Glinek/capibaraZero-FORK/Photos/20250617_205448.jpg

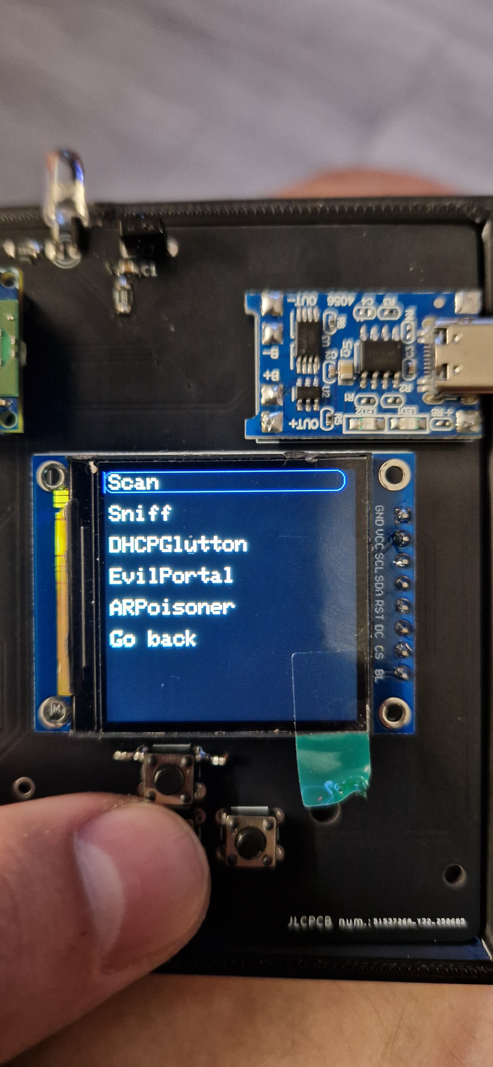
Photos/20250617_205448.jpg
