Glinek/capibaraZero-FORK/Photos/20250602_191517.jpg

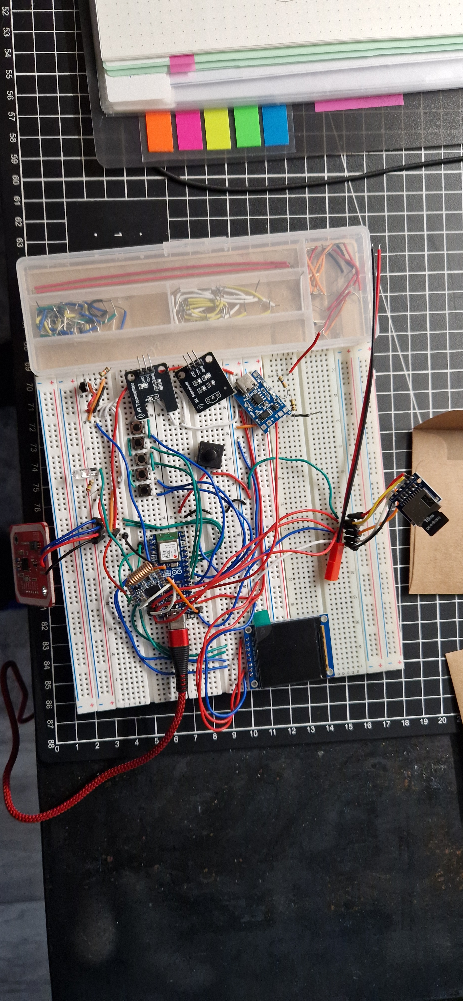
Photos/20250602_191517.jpg
