Glinek/capibaraZero-FORK/README.md

# CapibaraZero FORK
This repo contains PCBs designed by me for [the capibara zero](https://capibarazero.com/). 

### Gerber files are located under /KiCad/fabrication files for PCB
