Glinek/capibaraZero-FORK/Photos/20250513_170703.jpg

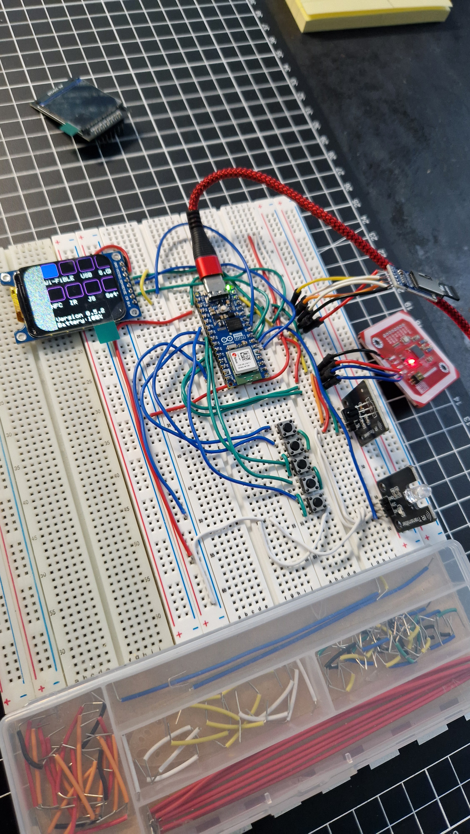
Photos/20250513_170703.jpg
