Glinek/capibaraZero-FORK/Photos/20250602_181604.jpg

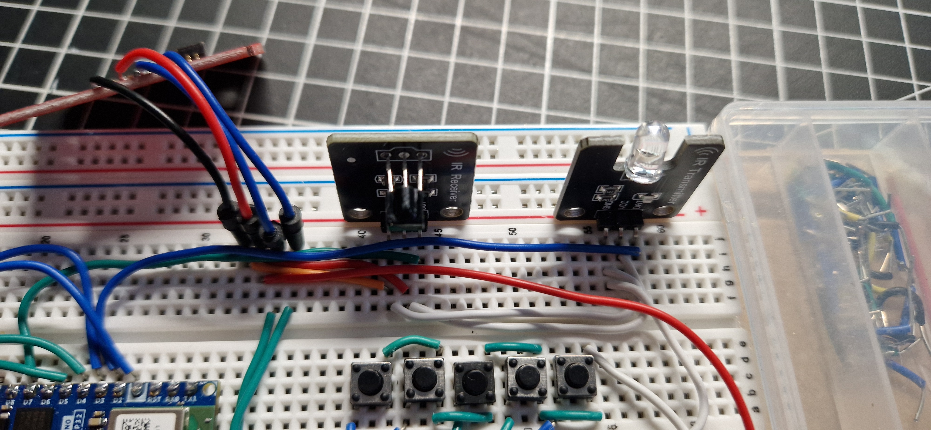
Photos/20250602_181604.jpg
