Glinek/capibaraZero-FORK/Photos/20250602_191530.jpg

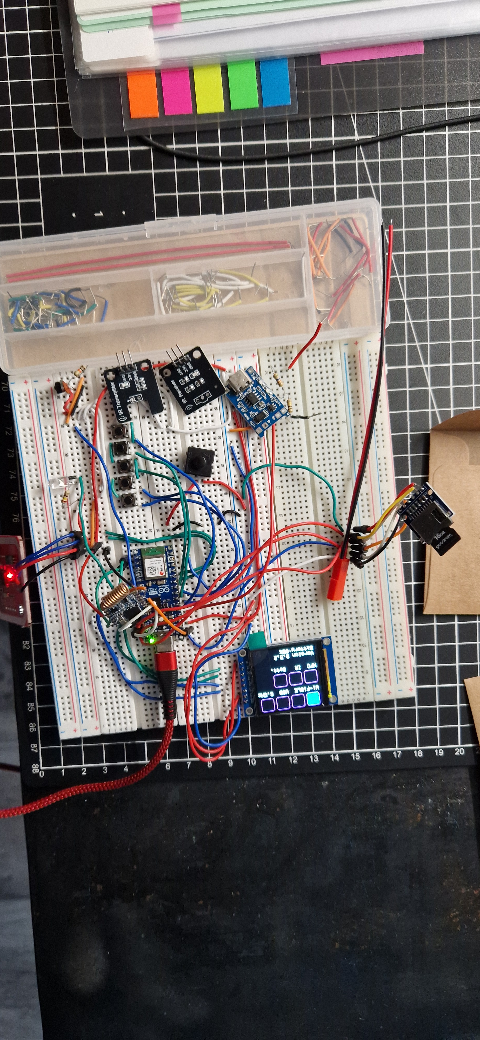
Photos/20250602_191530.jpg
