Glinek/capibaraZero-FORK/Photos/20250604_070136.jpg

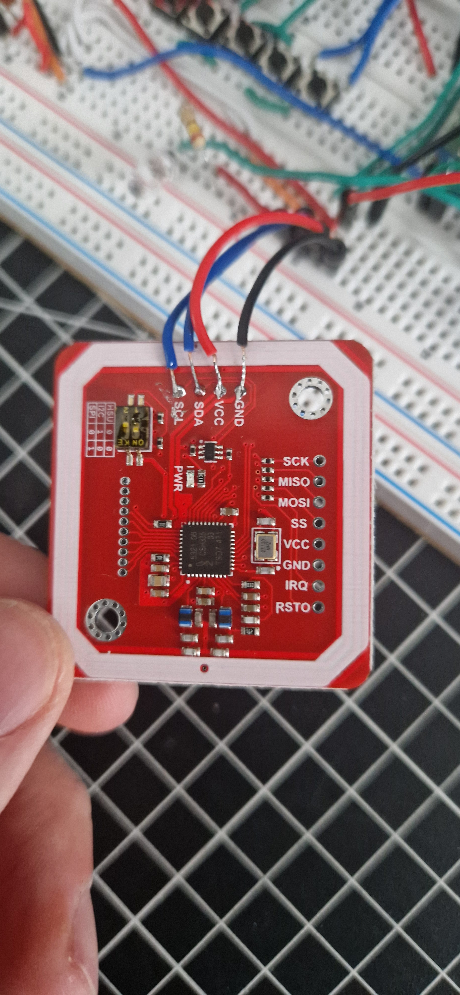
Photos/20250604_070136.jpg
