Glinek/capibaraZero-FORK/Photos/20250604_070140.jpg

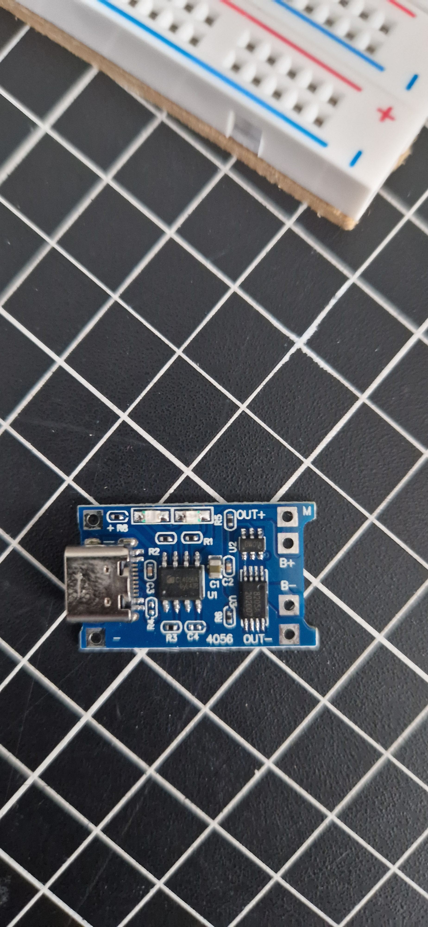
Photos/20250604_070140.jpg
