Glinek/capibaraZero-FORK/Photos/20250604_070147.jpg

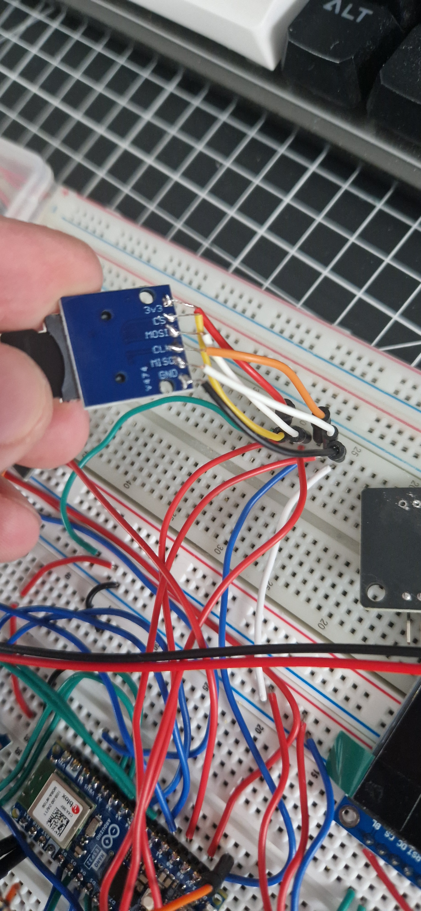
Photos/20250604_070147.jpg
