Glinek/capibaraZero-FORK/Photos/20250616_064222.jpg

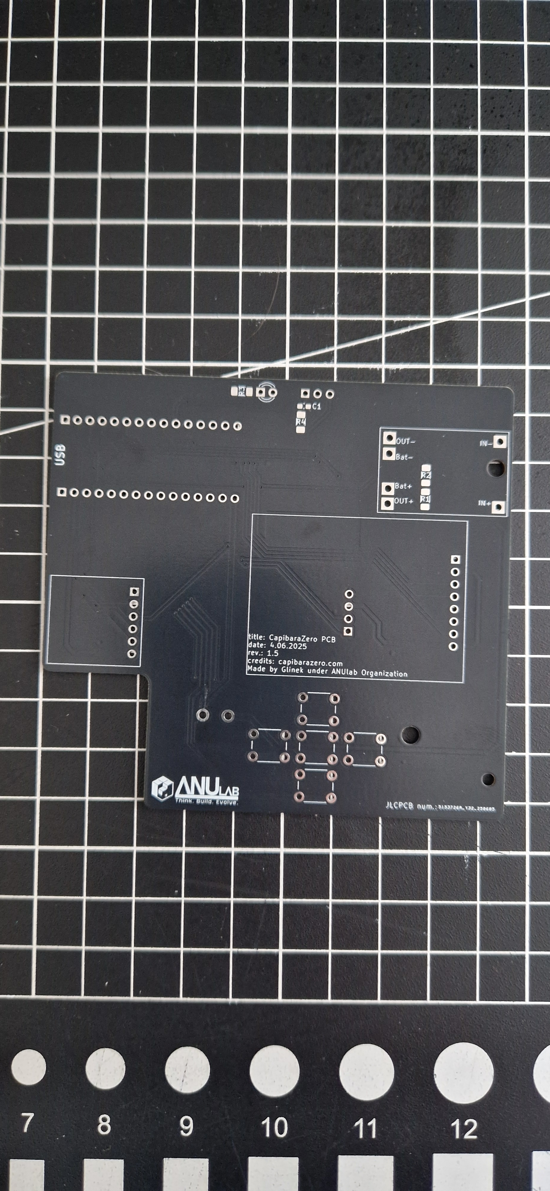
Photos/20250616_064222.jpg
