Glinek/capibaraZero-FORK/Photos/20250616_184949.jpg

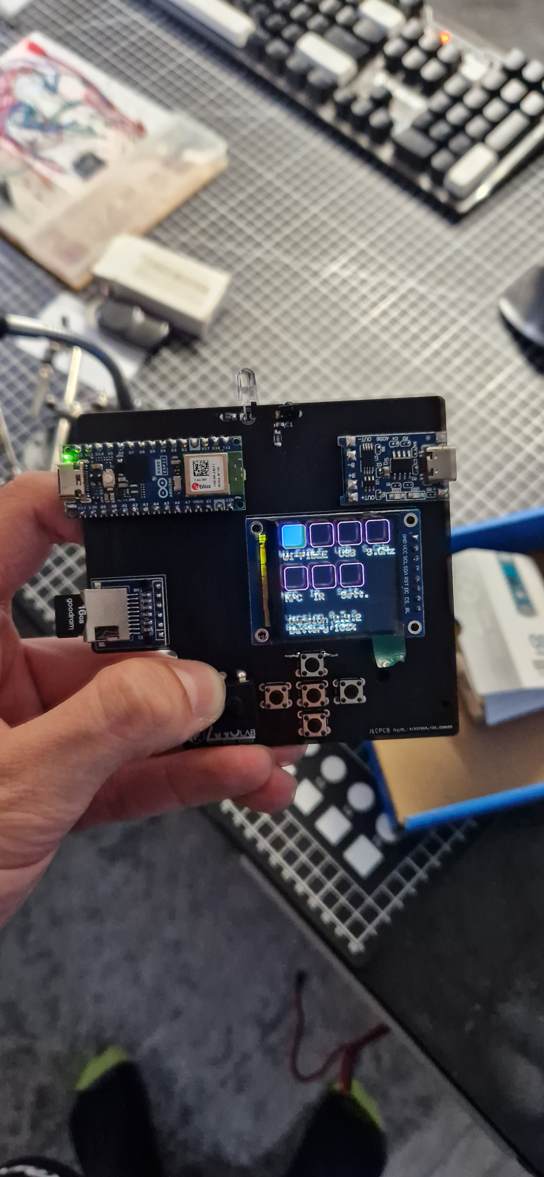
Photos/20250616_184949.jpg
