Glinek/capibaraZero-FORK/Photos/20250616_184953.jpg

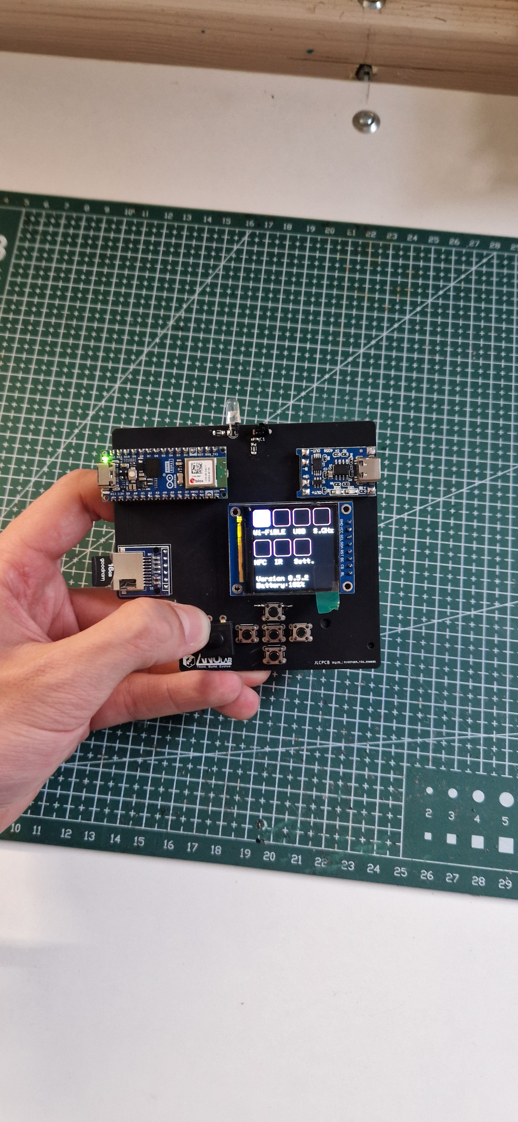
Photos/20250616_184953.jpg
