Glinek/capibaraZero-FORK/Photos/20250616_184956.jpg

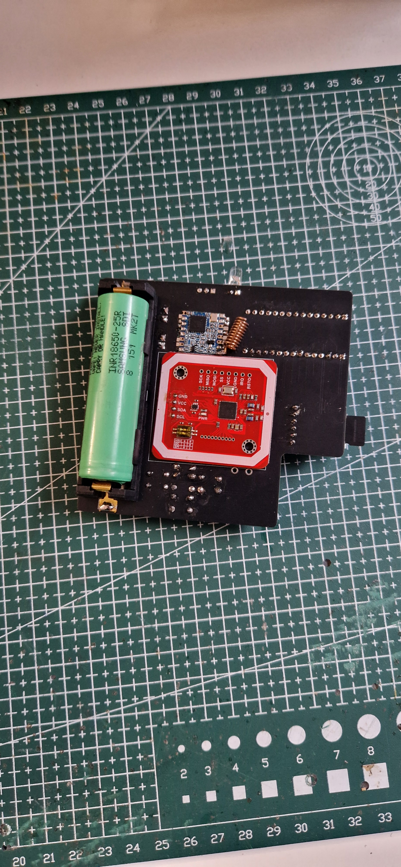
Photos/20250616_184956.jpg
