Glinek/capibaraZero-FORK/Photos/20250617_205459.jpg

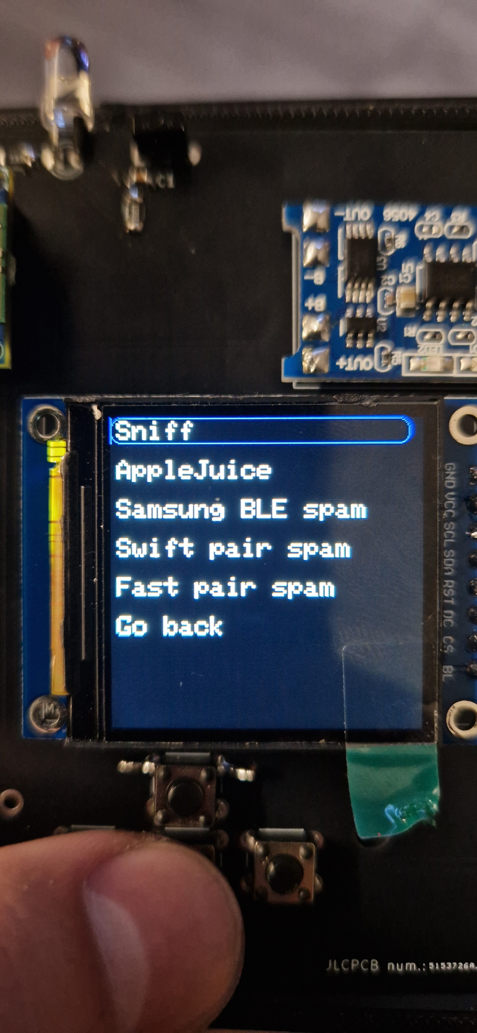
Photos/20250617_205459.jpg
