Glinek/capibaraZero-FORK/Photos/20250617_205542.jpg

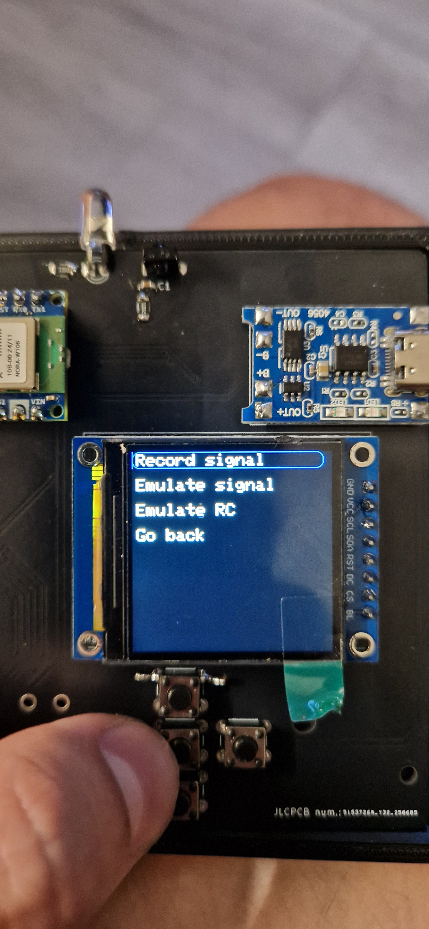
Photos/20250617_205542.jpg
