Glinek/capibaraZero-FORK/Photos/20250622_161914.jpg

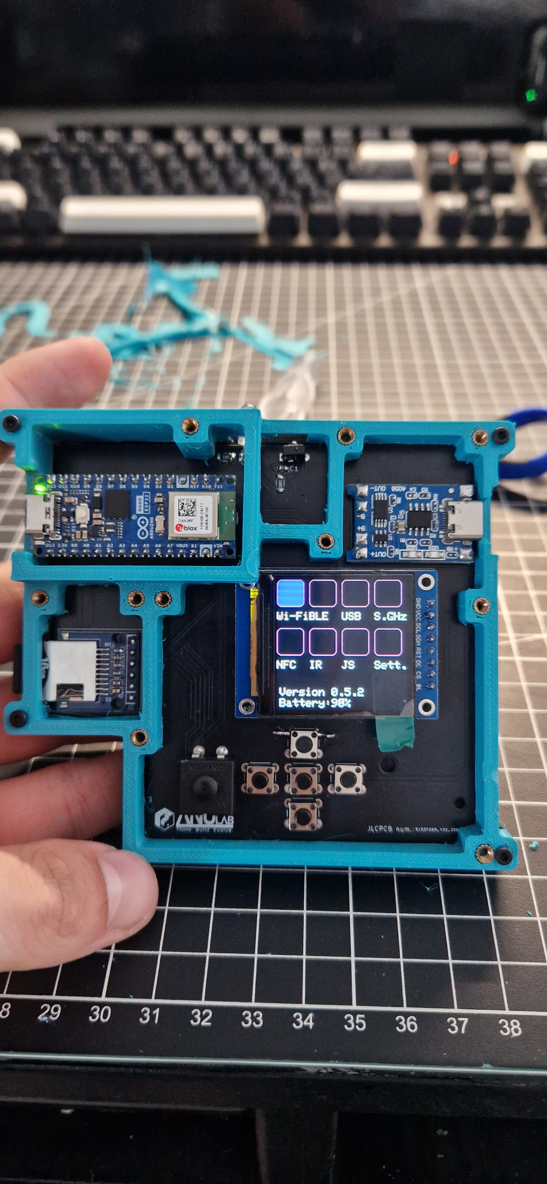
Photos/20250622_161914.jpg
