Glinek/capibaraZero-FORK/Photos/20250622_161920.jpg

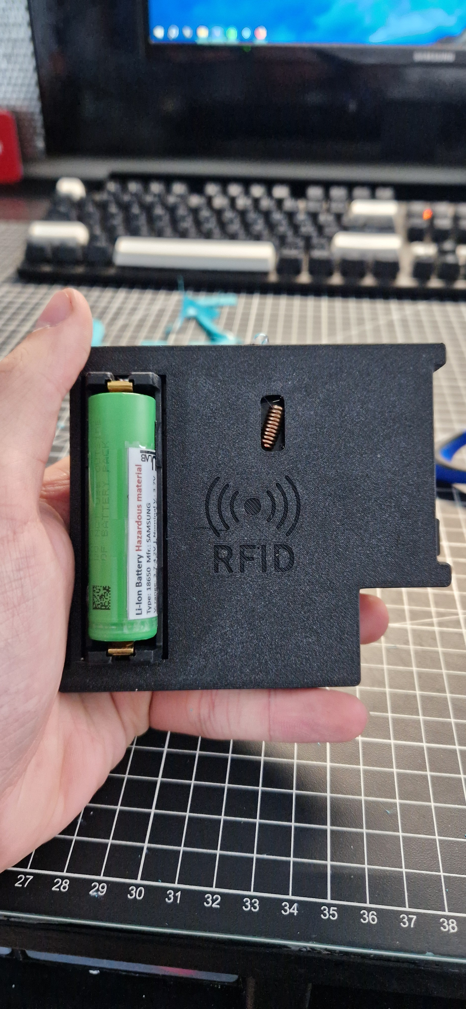
Photos/20250622_161920.jpg
