Glinek/capibaraZero-FORK/Photos/20250623_212616.jpg

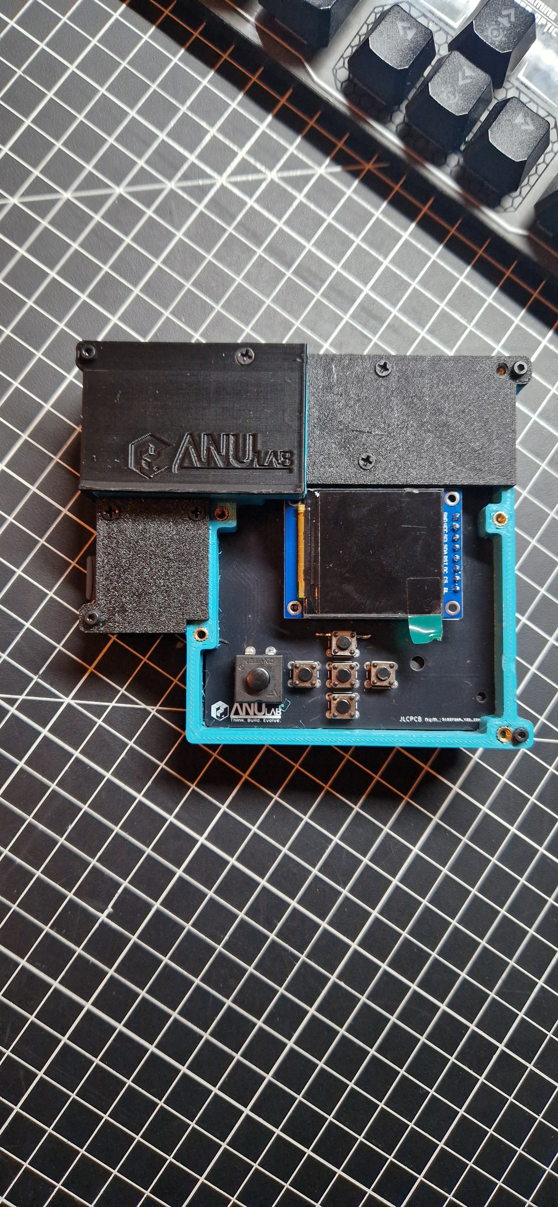
Photos/20250623_212616.jpg
