Glinek/capibaraZero-FORK/Photos/20250626_183406.jpg

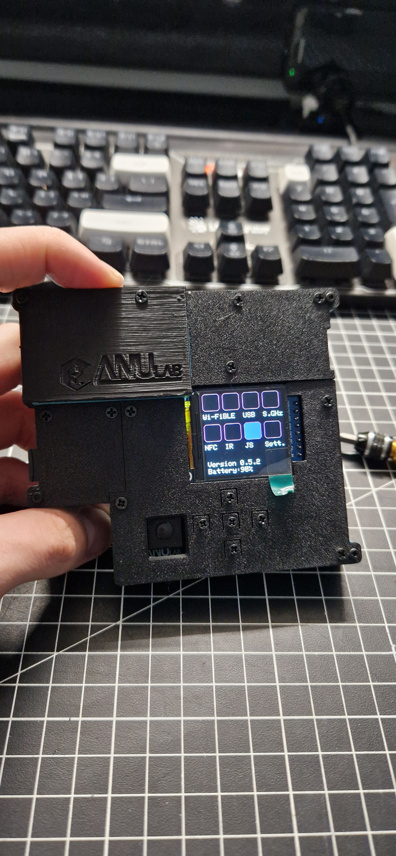
Photos/20250626_183406.jpg
