Glinek/capibaraZero-FORK/CAD files/FreeCAD/mainCover.FCStd

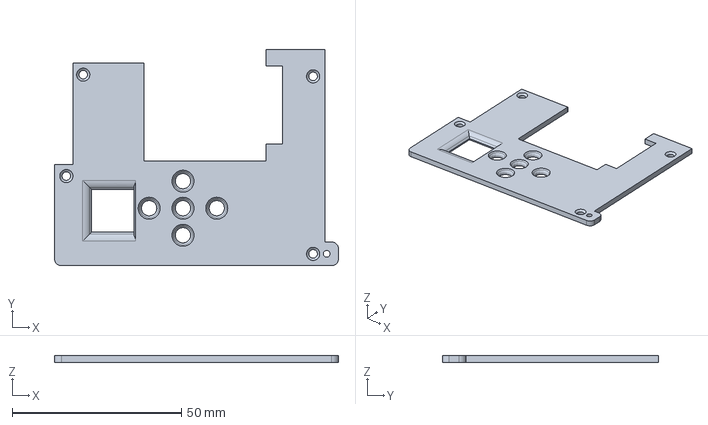
[picture p30: CAD file, 2025-11-09]
CAD files/FreeCAD/mainCover.FCStd
84.0 x 64.0 x 2.00 mm
