Glinek/capibaraZero-FORK/SD card folders/STLs/mainCover-v4.stl

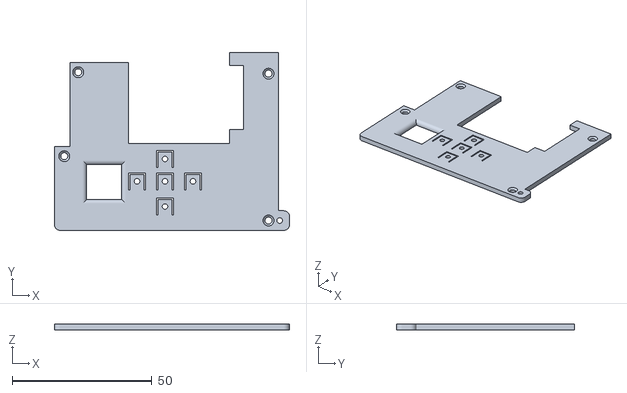
[picture p31: CAD file, 2025-06-26]
SD card folders/STLs/mainCover-v4.stl
84.0 x 63.5 x 2.00
