Glinek/capibaraZero-FORK/CAD files/FreeCAD/fullAssembly.FCStd

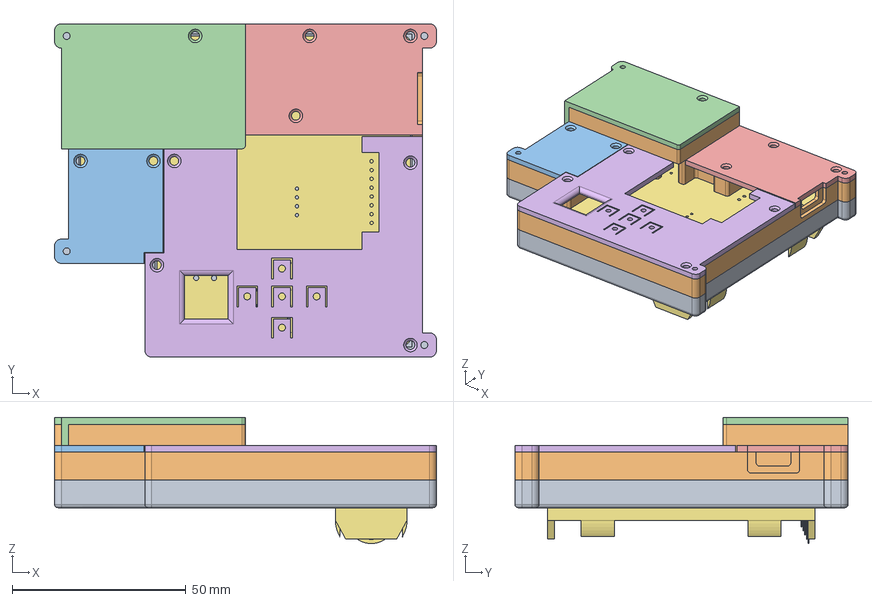
[picture p32: CAD file, 2025-06-26]
CAD files/FreeCAD/fullAssembly.FCStd
110.0 x 96.0 x 36.3 mm
bottomPart_001
topPart_001
sdCover_001
arduinoCover_001
irBmsCover_001
mainCover_001
capibarazeroPCB1_001
