Glinek/capibaraZero-FORK/CAD files/FreeCAD/arduinoCover.FCStd

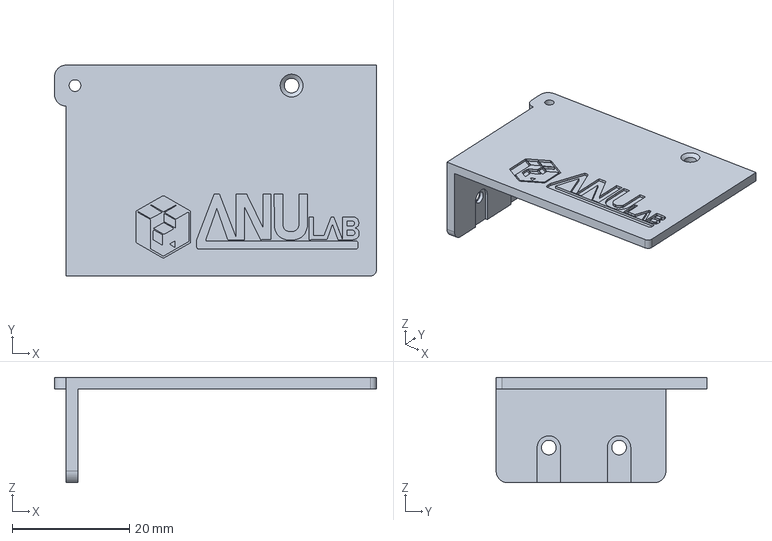
[picture p33: CAD file, 2025-06-26]
CAD files/FreeCAD/arduinoCover.FCStd
55.0 x 36.0 x 18.0 mm
