Glinek/capibaraZero-FORK/CAD files/STLs final/arduinoCover-v1,5.stl

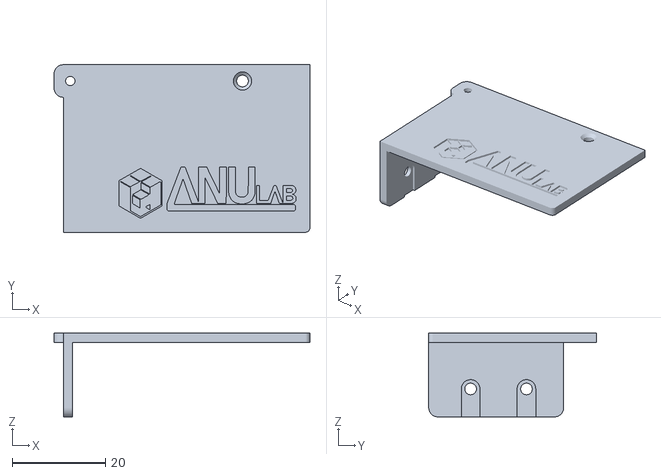
[picture p34: CAD file, 2025-06-26]
CAD files/STLs final/arduinoCover-v1,5.stl
55.0 x 36.0 x 18.0
