Glinek/capibaraZero-FORK/CAD files/STLs final/irBmsCove-v2.stl

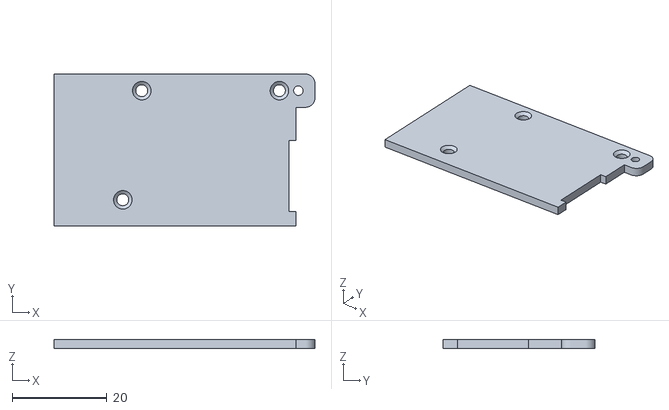
[picture p35: CAD file, 2025-06-26]
CAD files/STLs final/irBmsCove-v2.stl
55.0 x 32.0 x 2.00
