Glinek/capibaraZero-FORK/CAD files/STLs final/topPart-v3.stl

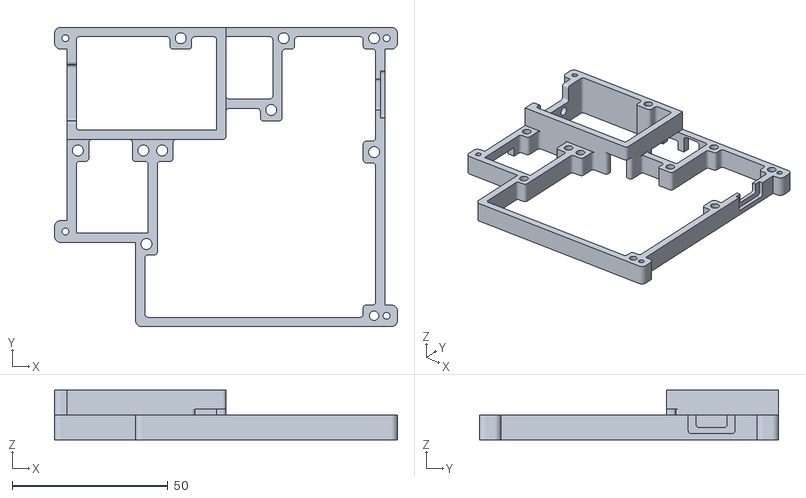
[picture p36: CAD file, 2025-06-26]
CAD files/STLs final/topPart-v3.stl
110.0 x 96.0 x 16.0
