Glinek/capibaraZero-FORK/CAD files/FreeCAD/sdCover.FCStd

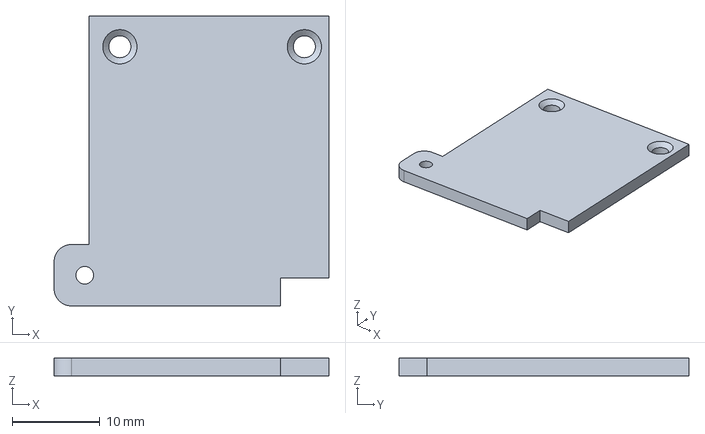
[picture p37: CAD file, 2025-06-26]
CAD files/FreeCAD/sdCover.FCStd
31.3 x 33.0 x 2.00 mm
