Glinek/capibaraZero-FORK/CAD files/FreeCAD/capibarazeroPCBv3.FCStd

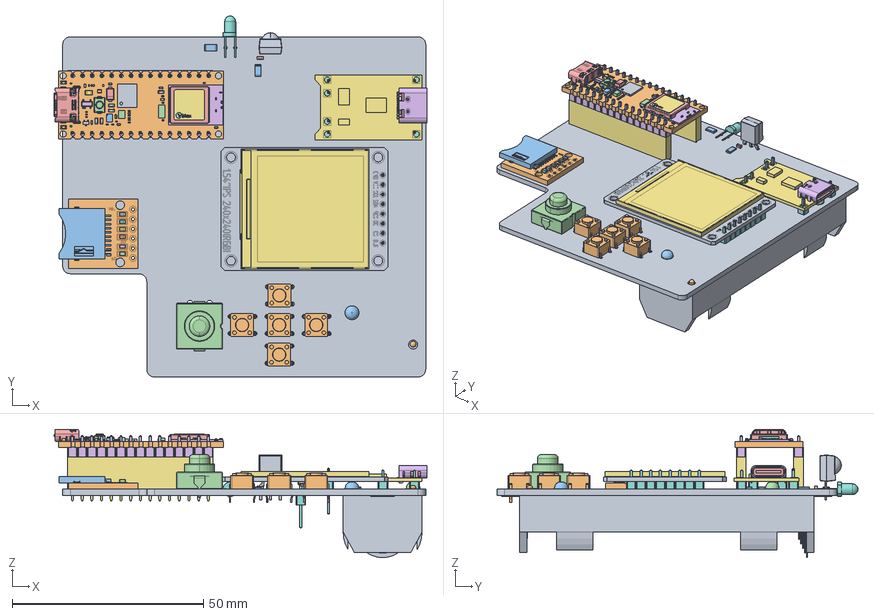
[picture p38: CAD file, 2025-06-26]
CAD files/FreeCAD/capibarazeroPCBv3.FCStd
97.6 x 94.5 x 33.6 mm
Pcb_4f59
SW3_M1_SW_PUSH_6mm_3d15108e469b x 5
R4_R_1206_3216Metric_c7ebed86450b x 4
SW1_YT-CB1212-112D_da829a2eec4a
C1_C_0603_1608Metric_f1cf9f5b2a91
J2_PinHeader_1x15_P254mm_Vertical_ef7361f10db6 x 2
J2_PinSocket_1x15_P2.54mm_Vertical_ef7361f10db6[2] x 2
BMS1_PinHeader_1x01_P254mm_Vertical_dd50c27e456c x 6
USB_type_C
USB_type_C001
USB_type_C002
USB_type_C003
USB_type_C004
USB_type_C005
USB_type_C006
USB_type_C007
USB_type_C008
USB_type_C009
USB_type_C010
USB_type_C011
USB_type_C012
USB_type_C013
USB_type_C014
USB_type_C015
USB_type_C016
USB_type_C017
USB_type_C018
USB_type_C019
USB_type_C020
USB_type_C021
USB_type_C022
USB_type_C023
USB_type_C024
USB_type_C025
USB_type_C026
USB_type_C027
USB_type_C028
USB_type_C029
USB_type_C030
USB_type_C031
USB_type_C032
USB_type_C033
USB_type_C034
USB_type_C035
USB_type_C036
USB_type_C037
D1_LED_D3.0mm_IRBlack_0430080c9509
J6_tsop4838_46909025a872
Micro SD Module - 1
MicroSD
0603 Capacitor
0603 Resistor
0603 Capacitor001
0603 Resistor001
0603 Resistor002
0603 Resistor003
CAP-0402
Extruded
CAP-0201
Extruded001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
