Glinek/capibaraZero-FORK/CAD files/STLs final/bottomPart-v2.stl

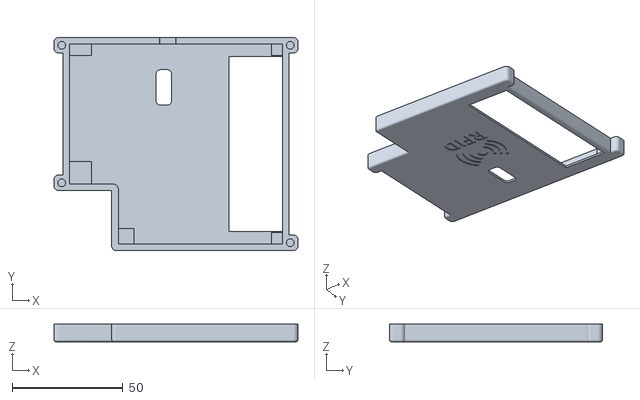
[picture p39: CAD file, 2025-06-17]
CAD files/STLs final/bottomPart-v2.stl
110.0 x 96.0 x 8.00
