Glinek/capibaraZero-FORK/CAD files/STLs/topPart-v2.5.stl

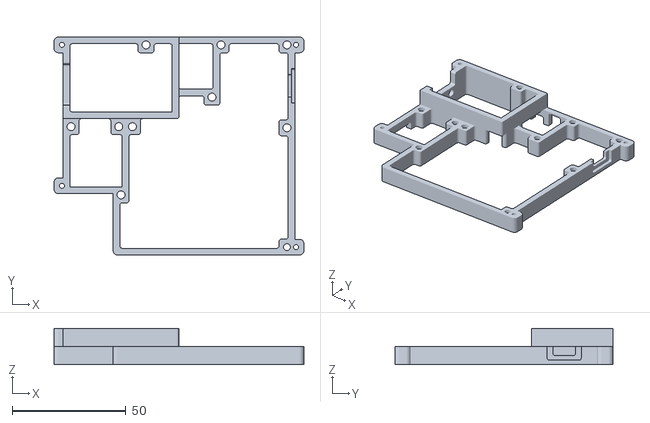
[picture p40: CAD file, 2025-06-26]
CAD files/STLs/topPart-v2.5.stl
110.0 x 96.0 x 16.0
