Glinek/capibaraZero-FORK/CAD files/FreeCAD/capibarazeroPCB1.FCStd

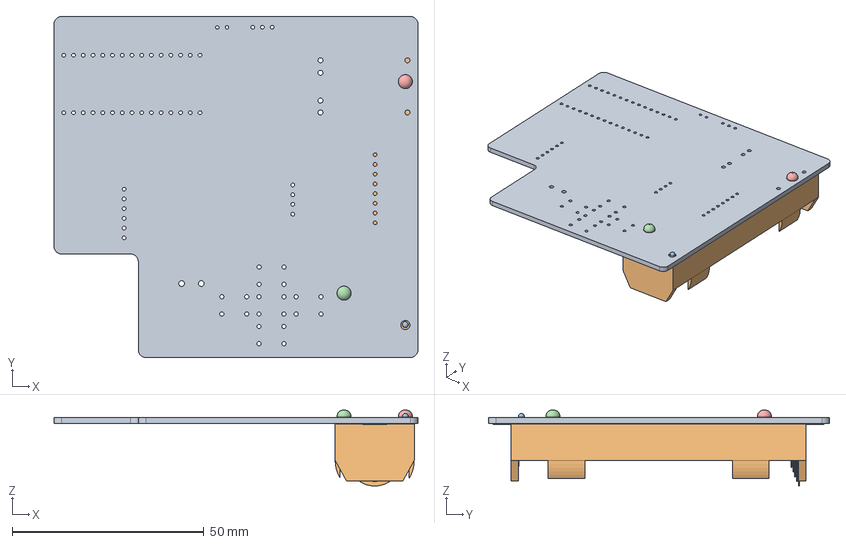
[picture p41: CAD file, 2025-06-16]
CAD files/FreeCAD/capibarazeroPCB1.FCStd
95.0 x 89.0 x 19.8 mm
Pcb_4f59
Keystone_1042_1x18650
Keystone_1042_1x18651
Keystone_1042_1x18652
Keystone_1042_1x18653
Keystone_1042_1x18654
Keystone_1042_1x18655
Keystone_1042_1x18656
Keystone_1042_1x18657
Keystone_1042_1x18658
