Glinek/capibaraZero-FORK/CAD files/STLs/irBmsCover-v1.stl

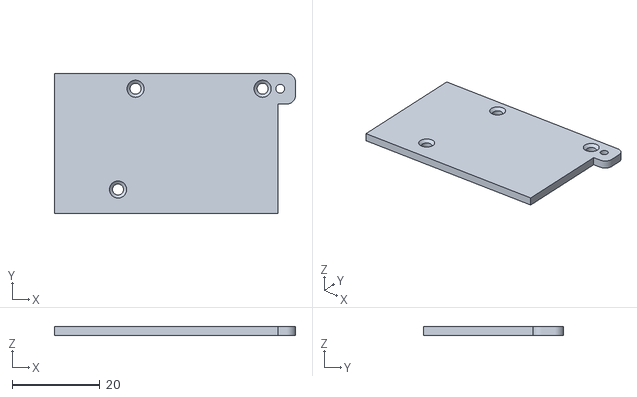
[picture p42: CAD file, 2025-06-26]
CAD files/STLs/irBmsCover-v1.stl
55.0 x 32.0 x 2.00
