Glinek/capibaraZero-FORK/(list of files, cad)

Other CAD files:
CAD files/STLs final/mainCover-v5.5.stl
CAD files/STLs/mainCover-v5.5.stl
CAD files/FreeCAD/irBmsCover.FCStd
CAD files/STLs final/sdCover-v1.stl
CAD files/STLs/arduinoCover-v1.stl
CAD files/FreeCAD/bottomPart.FCStd
CAD files/STLs/bottomPart-v1.stl
CAD files/STLs/mainCover-v1.stl
CAD files/STLs/mainCover-v2.stl
CAD files/STLs/mainCover-v3.stl
CAD files/STLs/mainCover-v5.stl
CAD files/STLs/topPart-v1.stl
CAD files/STLs/topPart-v2.stl
