Glinek/capibaraZero-FORK/KiCad/capibarazeroPCB/capibarazeroPCB.kicad_pcb

## KiCad design KiCad/capibarazeroPCB/capibarazeroPCB.kicad_pcb (2025-07-08)

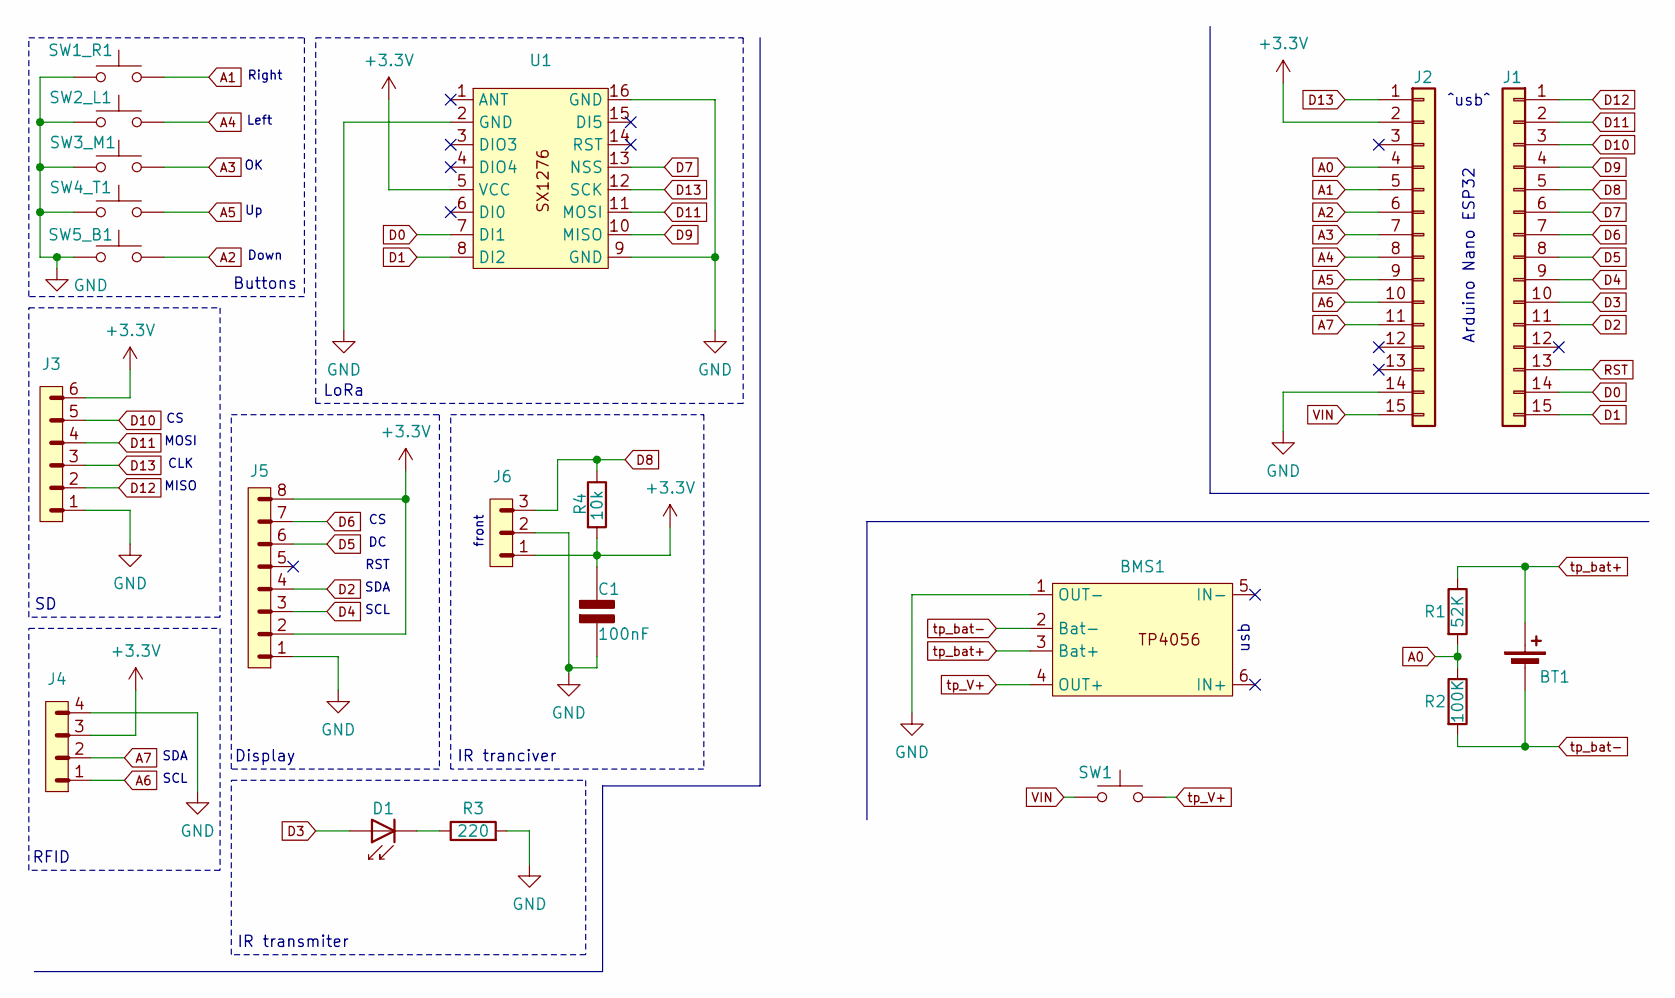
[picture p43: schematic capibarazeroPCB.kicad_sch, capibaraZero PCB]

Parts:
BMS1: tp4056_v2
BT1: Battery_Cell; BatteryHolder_Keystone_1042_1x18650
C1: 100nF; C_0603_1608Metric_Pad1.08x0.95mm_HandSolder; Rating V
D1: IR204A; LED_D3.0mm_IRBlack
J1, J2: Conn_01x15; PinHeader_1x15_P2.54mm_Vertical
J3: PINHD_1x6_Male; smd_connectorGeneric_1x6-2.54mm
J4: PINHD_1x4_Male; smd_connecorGeneric_1x4-2.54mm
J5: PINHD_1x8_Male; PinHeader_1x08_P2.54mm_Vertical
J6: PINHD_1x3_Male; PinHeader_1x03_P2.54mm_Vertical
R1: 52K; R_1206_3216Metric_Pad1.30x1.75mm_HandSolder
R2: 100K; R_1206_3216Metric_Pad1.30x1.75mm_HandSolder
R3: 220; R_1206_3216Metric_Pad1.30x1.75mm_HandSolder
R4: 10k; R_1206_3216Metric_Pad1.30x1.75mm_HandSolder
SW1: SW_Push; switch
SW1_R1, SW2_L1, SW3_M1, SW4_T1, SW5_B1: SW_Push; SW_PUSH_6mm
U1: sx1276LoRa

Connections:
+3.3V: C1.1 (+), J2.2, J3.6, J4.3, J5.2, J5.8, J6.1, R4.2, U1.5 (VCC)
A0: J2.4, R1.2, R2.1
A1: J2.5, SW1_R1.2
A2: J2.6, SW5_B1.2
A3: J2.7, SW3_M1.2
A4: J2.8, SW2_L1.2
A5: J2.9, SW4_T1.2
A6: J2.10, J4.1
A7: J2.11, J4.2
D0: J1.14, U1.7 (DI1)
D1: J1.15, U1.8 (DI2)
D2: J1.11, J5.4
D3: D1.2 (A), J1.10
D4: J1.9, J5.3
D5: J1.8, J5.6
D6: J1.7, J5.7
D7: J1.6, U1.13 (NSS)
D8: J1.5, J6.3, R4.1
D9: J1.4, U1.10 (MISO)
D10: J1.3, J3.5
D11: J1.2, J3.4, U1.11 (MOSI)
D12: J1.1, J3.2
D13: J2.1, J3.3, U1.12 (SCK)
GND: BMS1.1 (OUT-), C1.2 (-), J2.14, J3.1, J4.4, J5.1, J6.2, R3.2, SW1_R1.1, SW2_L1.1, SW3_M1.1, SW4_T1.1, SW5_B1.1, U1.2 (GND), U1.9 (GND), U1.16 (GND)
unnamed: D1.1 (K), R3.1
RST: J1.13
VIN: J2.15, SW1.1
tp_V+: BMS1.4 (OUT+), SW1.2
tp_bat+: BMS1.3 (Bat+), BT1.1 (+), R1.1
tp_bat-: BMS1.2 (Bat-), BT1.2 (-), R2.2

Notes on the sheet:
SCL
Down
Buttons
Right
Arduino Nano ESP32
IR transmiter
usb
RST
CLK
front
RFID
^usb^
LoRa
Display
SDA
MOSI
SDA
Left
IR tranciver
MISO

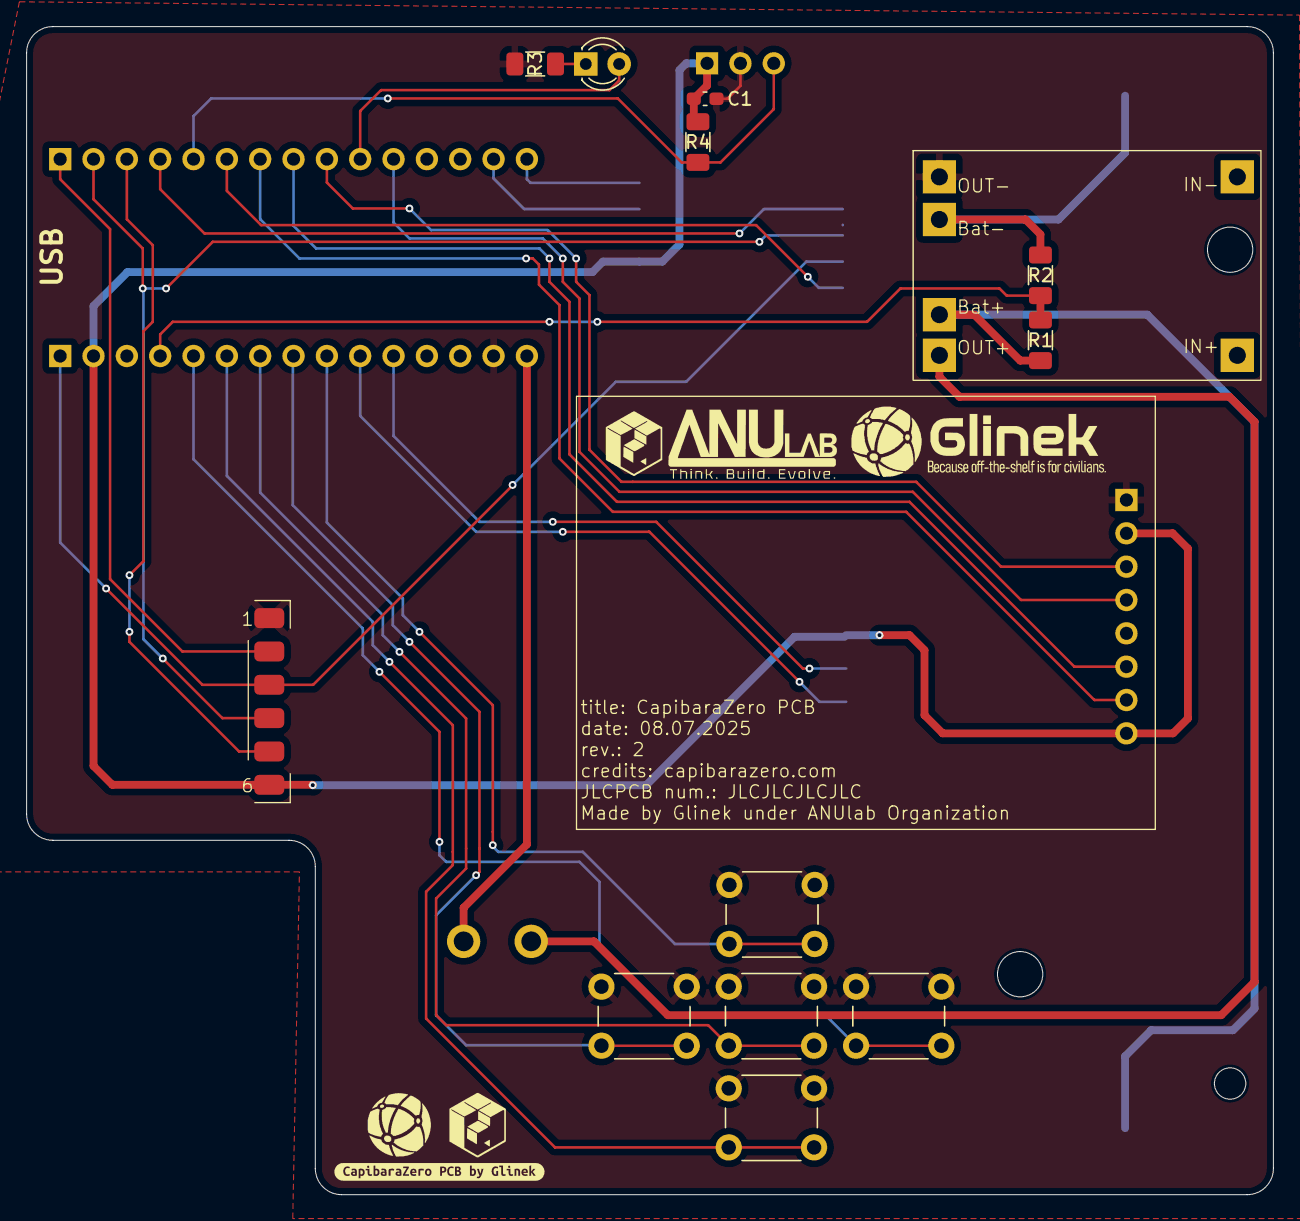
[picture p44: board capibarazeroPCB.kicad_pcb from above]

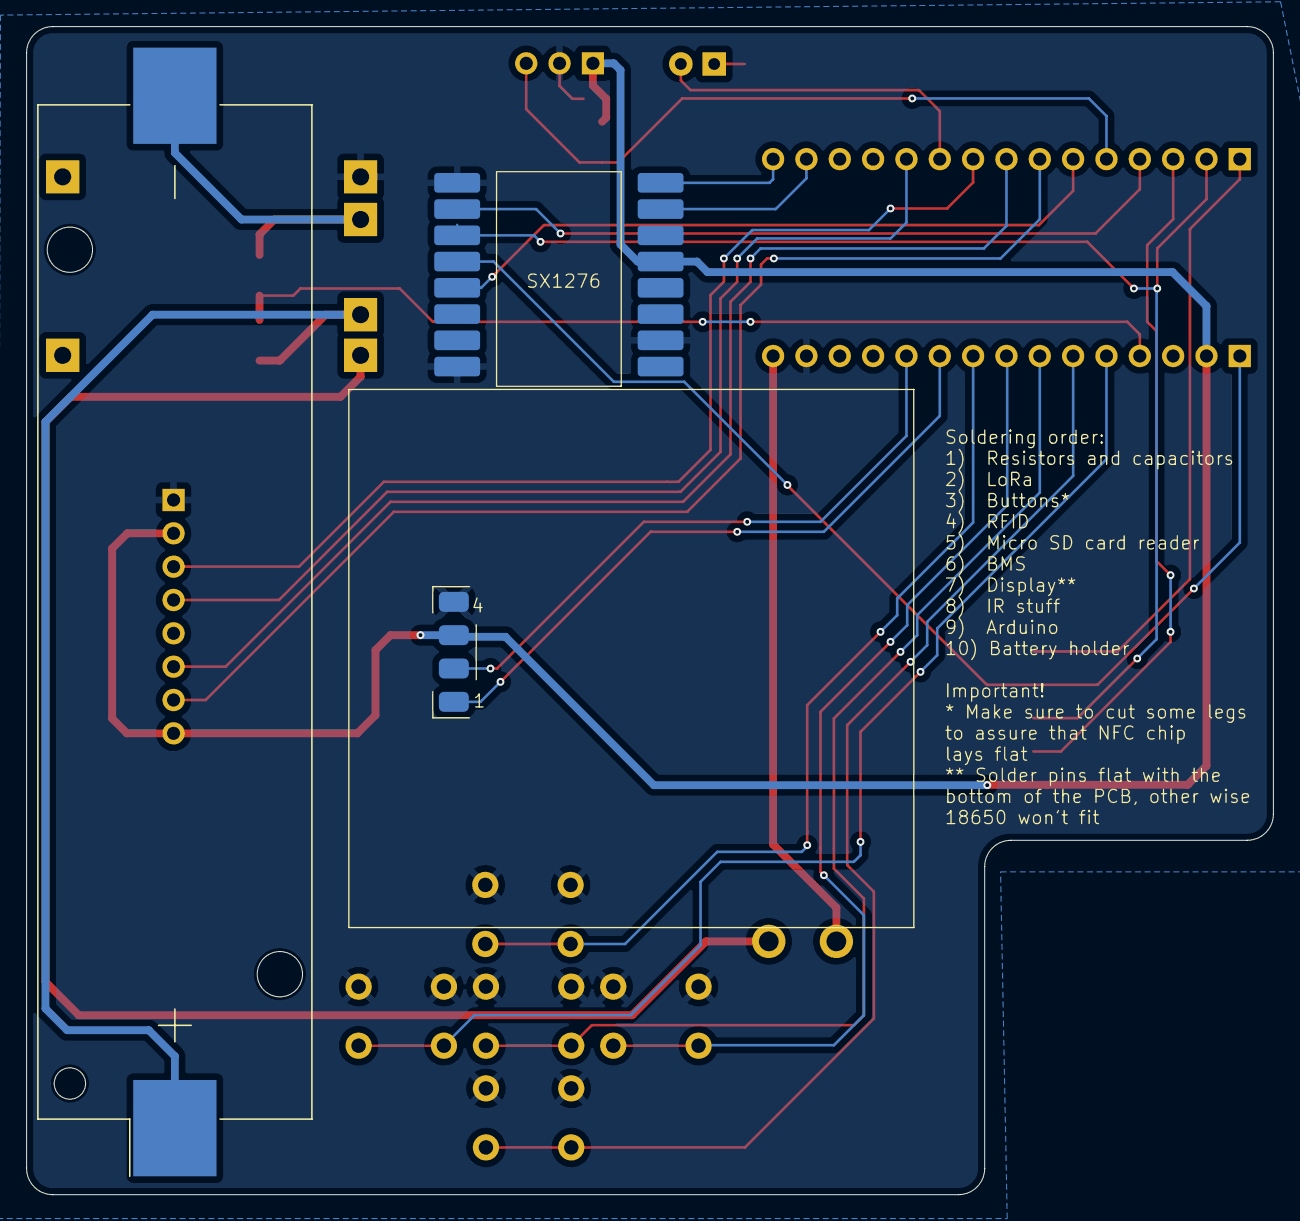
[picture p45: board capibarazeroPCB.kicad_pcb from below]

Board: 2 copper layers, 95.0 x 89.0 mm, 22 parts (3 on the bottom side), 29 nets.

Other parts of the board:
kibuzzard-686CF35A: G***; kibuzzard-686CF35A
