Glinek/capibaraZero-FORK/(commit log)

2025-06-17 model update
    [bottomPart-v1.stl, bottomPart-v2.stl, bottomPart.FCStd, fullAssembly.FCStd, topPart-v1.stl, topPart.FCStd]
2025-06-26 case finished
    [arduinoCover-v1,5.stl, arduinoCover-v1.stl, arduinoCover.FCStd, capibarazeroPCB.kicad_pcb, capibarazeroPCBv3.FCStd, fullAssembly.FCStd, irBmsCove-v2.stl, irBmsCover-v1.stl]
2025-07-08 pcb update to rev2 - 08.07.2025
    [arduinoCover-v1,5.stl, bottomPart-v2.stl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]
2025-11-09 minor update
    [arduinoCover-v1,5.stl, bottomPart-v2.stl, irBmsCove-v2.stl, mainCover-v5.5.stl, mainCover-v5.stl, mainCover.FCStd, sdCover-v1.stl, topPart-v3.stl]
